stdnt-c1/Personal-Project/images/post-revision/controller_back_bottom.jpg

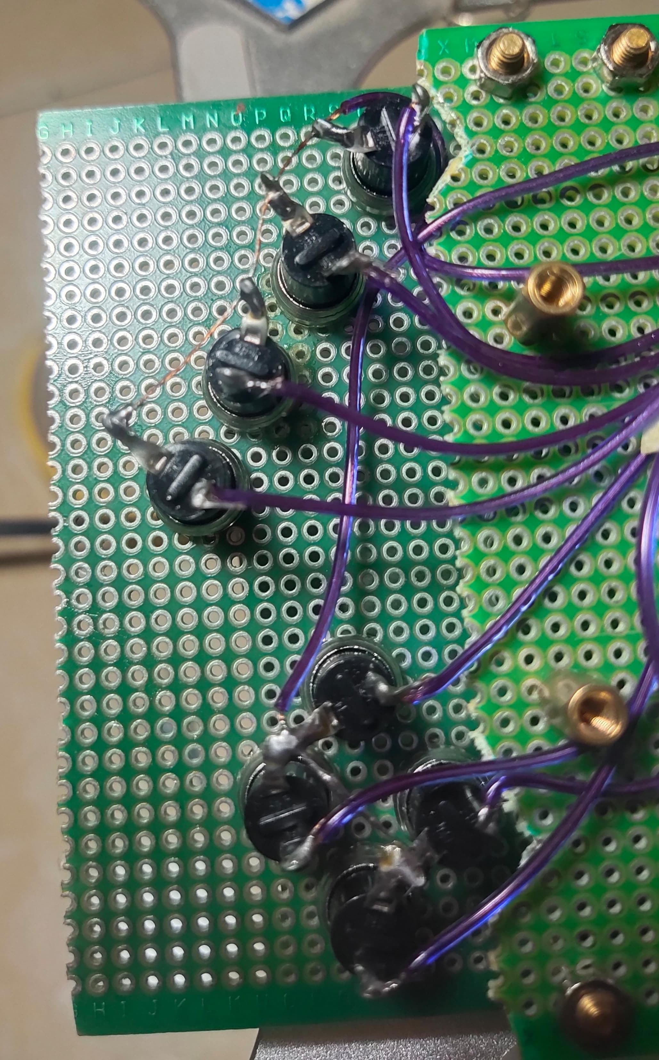
images/post-revision/controller_back_bottom.jpg
