stdnt-c1/Personal-Project/images/post-revision/controller_back_middle.jpg

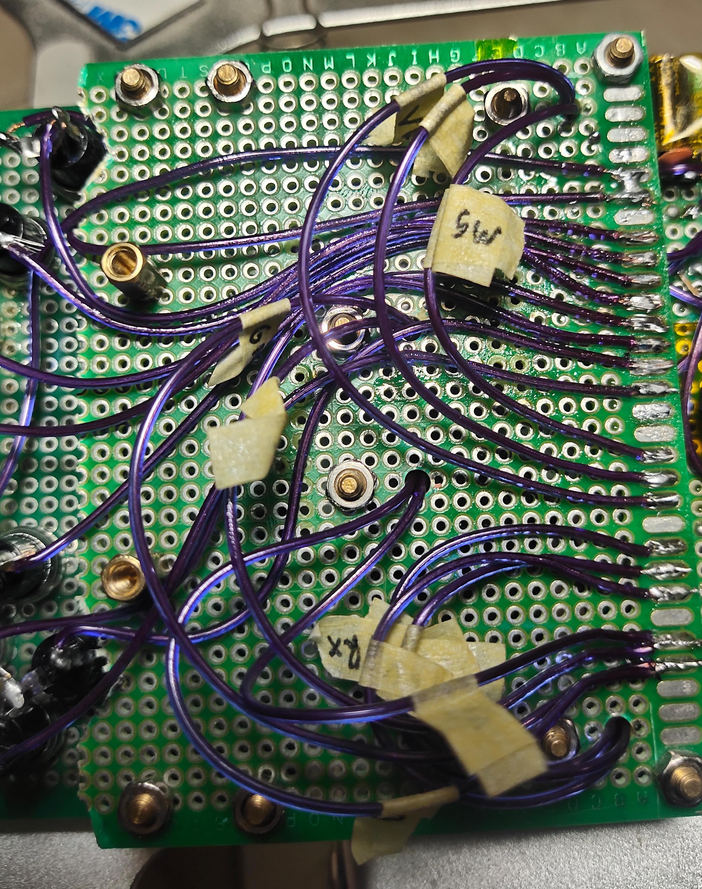
images/post-revision/controller_back_middle.jpg
