stdnt-c1/Personal-Project/src/JoyStick.ino

/**
 * ESP32-based Wireless Joystick Implementation
 * @version 1.0.0-beta.1
 * @author stndnt-c1 [https://github.com/stdnt-c1]
 */

// Libraries
#include <Wire.h>          // For I2C communication
#include <SPI.h>           // For SPI communication
#include <RF24.h>          // For NRF24L01
#include <Adafruit_GFX.h>  // For OLED display
#include <Adafruit_SSD1306.h> // For OLED display

// Pin Definitions
#define LEFT_JOY_X_PIN    34  // Left joystick X axis
#define LEFT_JOY_Y_PIN    35  // Left joystick Y axis
#define RIGHT_JOY_X_PIN   36  // Right joystick X axis
#define RIGHT_JOY_Y_PIN   39  // Right joystick Y axis
#define LEFT_BUTTONS_PIN  32  // Left button matrix
#define RIGHT_BUTTONS_PIN 33  // Right button matrix
#define TRIGGER_L1        25  // Left trigger 1
#define TRIGGER_L2        26  // Left trigger 2
#define TRIGGER_R1        27  // Right trigger 1
#define TRIGGER_R2        14  // Right trigger 2
#define BUZZER_PIN       12  // Buzzer for feedback

// RF24 Configuration
RF24 radio(5, 4); // CE, CSN pins
const byte address[6] = "00001";

// OLED Display Configuration
#define SCREEN_WIDTH 64
#define SCREEN_HEIGHT 48
#define OLED_RESET    -1
Adafruit_SSD1306 display(SCREEN_WIDTH, SCREEN_HEIGHT, &Wire, OLED_RESET);

void setup() {
  // Initialize serial for debugging
  Serial.begin(115200);
  
  // Initialize pins
  setupPins();
  
  // Initialize RF module
  setupRF();
  
  // Initialize display
  setupDisplay();
}

void loop() {
  // Read all inputs
  readJoysticks();
  readButtons();
  readTriggers();
  
  // Update display
  updateDisplay();
  
  // Send data
  sendData();
  
  // Small delay to prevent too frequent updates
  delay(10);
}

// Implementation of setup functions will go here
void setupPins() {
  // TODO: Initialize all pins with appropriate modes
}

void setupRF() {
  // TODO: Initialize RF module with proper configuration
}

void setupDisplay() {
  // TODO: Initialize OLED display
}

// Implementation of input reading functions will go here
void readJoysticks() {
  // TODO: Read and process joystick inputs
}

void readButtons() {
  // TODO: Read and process button matrix inputs
}

void readTriggers() {
  // TODO: Read and process trigger inputs
}

void updateDisplay() {
  // TODO: Update OLED display with current status
}

void sendData() {
  // TODO: Send data packet via RF module
}
