stdnt-c1/Personal-Project/(commit log)

2025-06-06 update: pin mapping and further planning
2025-06-08 update: revised wiring diagram and implemntation update, refer to LOG-4 in log
2025-06-09 update: switch revision and gate protection, refer to LOG-6 in log
