stdnt-c1/Personal-Project/(notices)

Notices in the files:
README.md:
License: MIT
